zeevro/game-pad/pcb/gamepad-pcb.kicad_pcb

## KiCad design pcb/gamepad-pcb.kicad_pcb (2024-05-09)

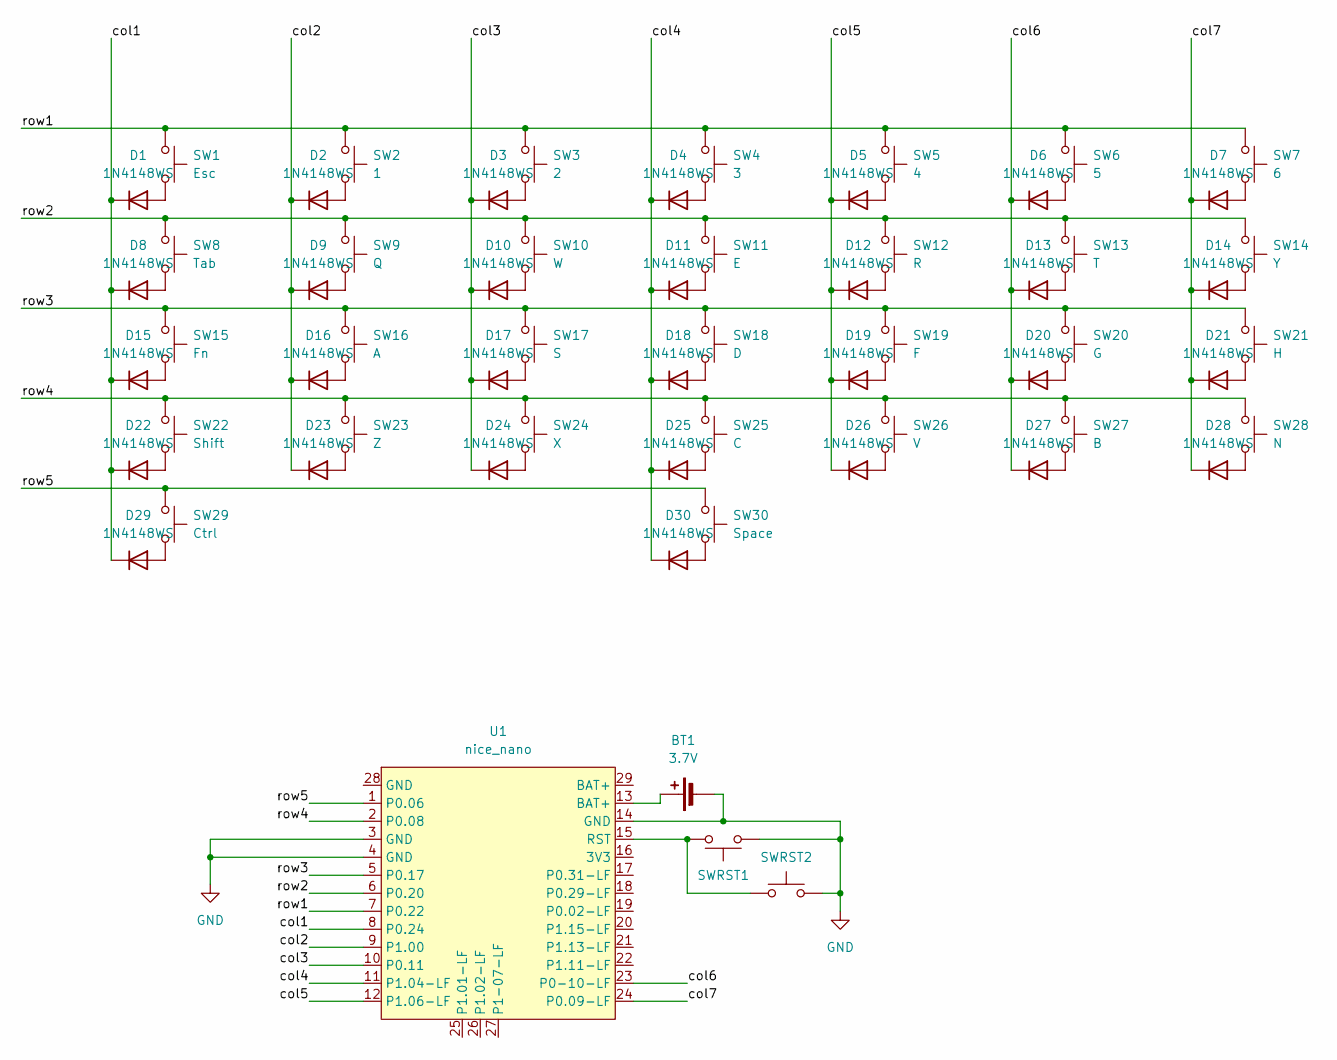
[picture p1: schematic gamepad-pcb.kicad_sch]

Parts:
BT1: 3.7V; PinHeader_1x02_P2.54mm_Vertical
D1, D2, D3, D4, D5, D6, D7, D8, D9, D10, D11, D12, D13, D14, D15, D16, D17, D18, D19, D20, D21, D22, D23, D24, D25, D26, D27, D28, D29, D30: 1N4148WS; D_SOD-323_HandSoldering
SW1: Esc; SW_Cherry_MX_PCB_1.00u
SW2: 1; SW_Cherry_MX_PCB_1.00u
SW3: 2; SW_Cherry_MX_PCB_1.00u
SW4: 3; SW_Cherry_MX_PCB_1.00u
SW5: 4; SW_Cherry_MX_PCB_1.00u
SW6: 5; SW_Cherry_MX_PCB_1.00u
SW7: 6; SW_Cherry_MX_PCB_1.00u
SW8: Tab; SW_Cherry_MX_PCB_1.50u
SW9: Q; SW_Cherry_MX_PCB_1.00u
SW10: W; SW_Cherry_MX_PCB_1.00u
SW11: E; SW_Cherry_MX_PCB_1.00u
SW12: R; SW_Cherry_MX_PCB_1.00u
SW13: T; SW_Cherry_MX_PCB_1.00u
SW14: Y; SW_Cherry_MX_PCB_1.00u
SW15: Fn; SW_Cherry_MX_PCB_1.25u
SW16: A; SW_Cherry_MX_PCB_1.00u
SW17: S; SW_Cherry_MX_PCB_1.00u
SW18: D; SW_Cherry_MX_PCB_1.00u
SW19: F; SW_Cherry_MX_PCB_1.00u
SW20: G; SW_Cherry_MX_PCB_1.00u
SW21: H; SW_Cherry_MX_PCB_1.00u
SW22: Shift; SW_Cherry_MX_PCB_1.75u
SW23: Z; SW_Cherry_MX_PCB_1.00u
SW24: X; SW_Cherry_MX_PCB_1.00u
SW25: C; SW_Cherry_MX_PCB_1.00u
SW26: V; SW_Cherry_MX_PCB_1.00u
SW27: B; SW_Cherry_MX_PCB_1.00u
SW28: N; SW_Cherry_MX_PCB_1.00u
SW29: Ctrl; SW_Cherry_MX_PCB_1.25u
SW30: Space; SW_Cherry_MX_PCB_6.25u
SWRST1, SWRST2: SW_SPST_B3U-1000P
U1: nice_nano; nice_nano_H_USBup

Connections:
/col1: D1.1 (K), D8.1 (K), D15.1 (K), D22.1 (K), D29.1 (K), U1.8 (P0.24)
/col2: D2.1 (K), D9.1 (K), D16.1 (K), D23.1 (K), U1.9 (P1.00)
/col3: D3.1 (K), D10.1 (K), D17.1 (K), D24.1 (K), U1.10 (P0.11)
/col4: D4.1 (K), D11.1 (K), D18.1 (K), D25.1 (K), D30.1 (K), U1.11 (P1.04-LF)
/col5: D5.1 (K), D12.1 (K), D19.1 (K), D26.1 (K), U1.12 (P1.06-LF)
/col6: D6.1 (K), D13.1 (K), D20.1 (K), D27.1 (K), U1.23 (P0-10-LF)
/col7: D7.1 (K), D14.1 (K), D21.1 (K), D28.1 (K), U1.24 (P0.09-LF)
/row1: SW1.1, SW2.1, SW3.1, SW4.1, SW5.1, SW6.1, SW7.1, U1.7 (P0.22)
/row2: SW8.1, SW9.1, SW10.1, SW11.1, SW12.1, SW13.1, SW14.1, U1.6 (P0.20)
/row3: SW15.1, SW16.1, SW17.1, SW18.1, SW19.1, SW20.1, SW21.1, U1.5 (P0.17)
/row4: SW22.1, SW23.1, SW24.1, SW25.1, SW26.1, SW27.1, SW28.1, U1.2 (P0.08)
/row5: SW29.1, SW30.1, U1.1 (P0.06)
GND: BT1.2 (-), SWRST1.2, SWRST2.2, U1.3 (GND), U1.4 (GND), U1.14 (GND)
unnamed: BT1.1 (+), U1.13 (BAT+)
unnamed: D1.2 (A), SW1.2
unnamed: D2.2 (A), SW2.2
unnamed: D3.2 (A), SW3.2
unnamed: D4.2 (A), SW4.2
unnamed: D5.2 (A), SW5.2
unnamed: D6.2 (A), SW6.2
unnamed: D7.2 (A), SW7.2
unnamed: D8.2 (A), SW8.2
unnamed: D9.2 (A), SW9.2
unnamed: D10.2 (A), SW10.2
unnamed: D11.2 (A), SW11.2
unnamed: D12.2 (A), SW12.2
unnamed: D13.2 (A), SW13.2
unnamed: D14.2 (A), SW14.2
unnamed: D15.2 (A), SW15.2
unnamed: D16.2 (A), SW16.2
unnamed: D17.2 (A), SW17.2
unnamed: D18.2 (A), SW18.2
unnamed: D19.2 (A), SW19.2
unnamed: D20.2 (A), SW20.2
unnamed: D21.2 (A), SW21.2
unnamed: D22.2 (A), SW22.2
unnamed: D23.2 (A), SW23.2
unnamed: D24.2 (A), SW24.2
unnamed: D25.2 (A), SW25.2
unnamed: D26.2 (A), SW26.2
unnamed: D27.2 (A), SW27.2
unnamed: D28.2 (A), SW28.2
unnamed: D29.2 (A), SW29.2
unnamed: D30.2 (A), SW30.2
unnamed: SWRST1.1, SWRST2.1, U1.15 (RST)

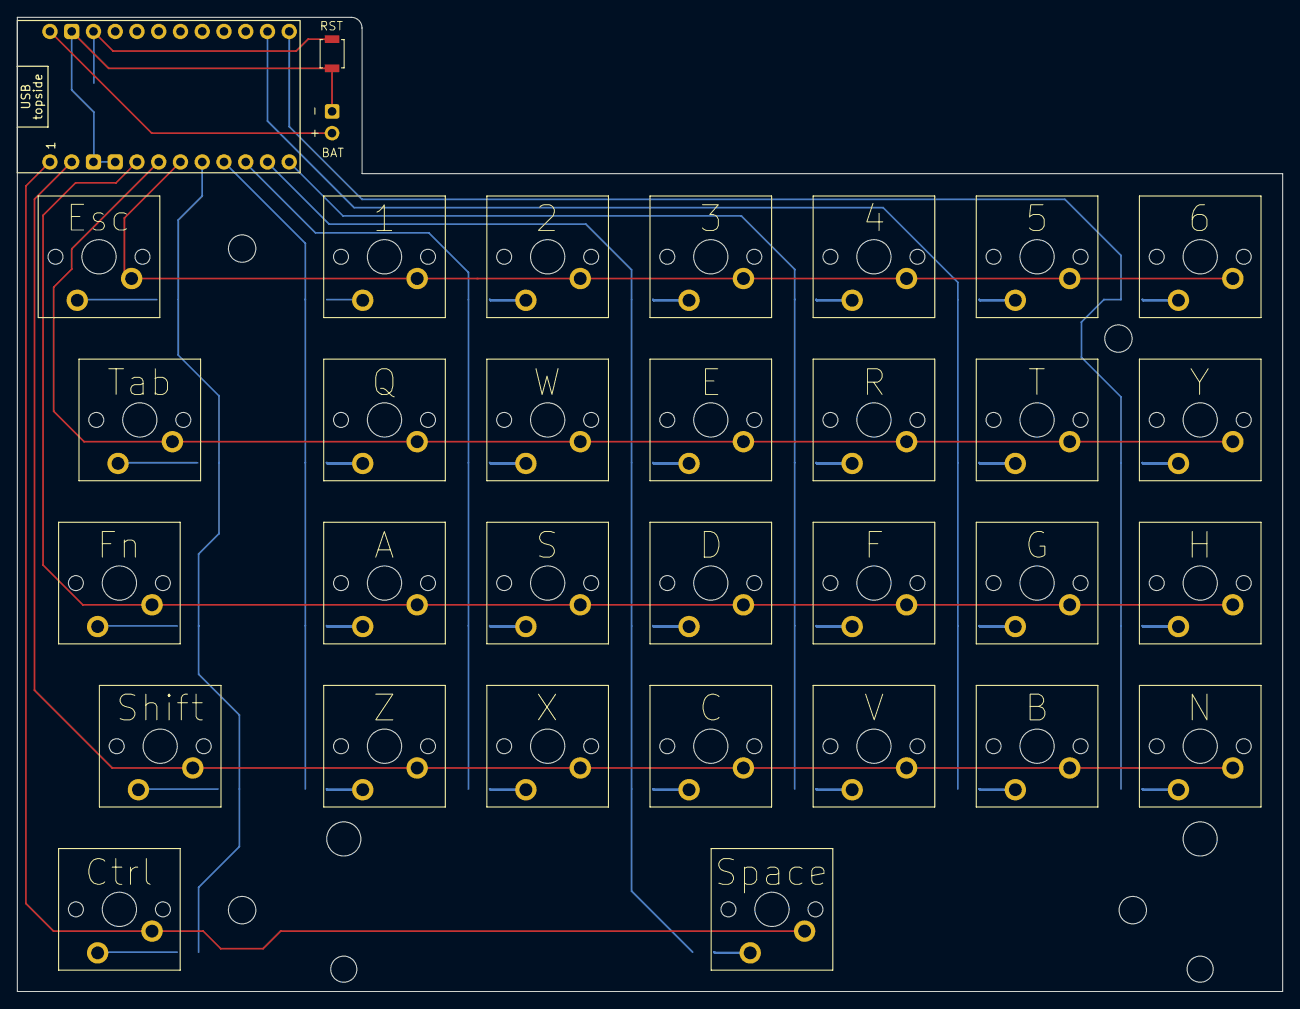
[picture p2: board gamepad-pcb.kicad_pcb from above]

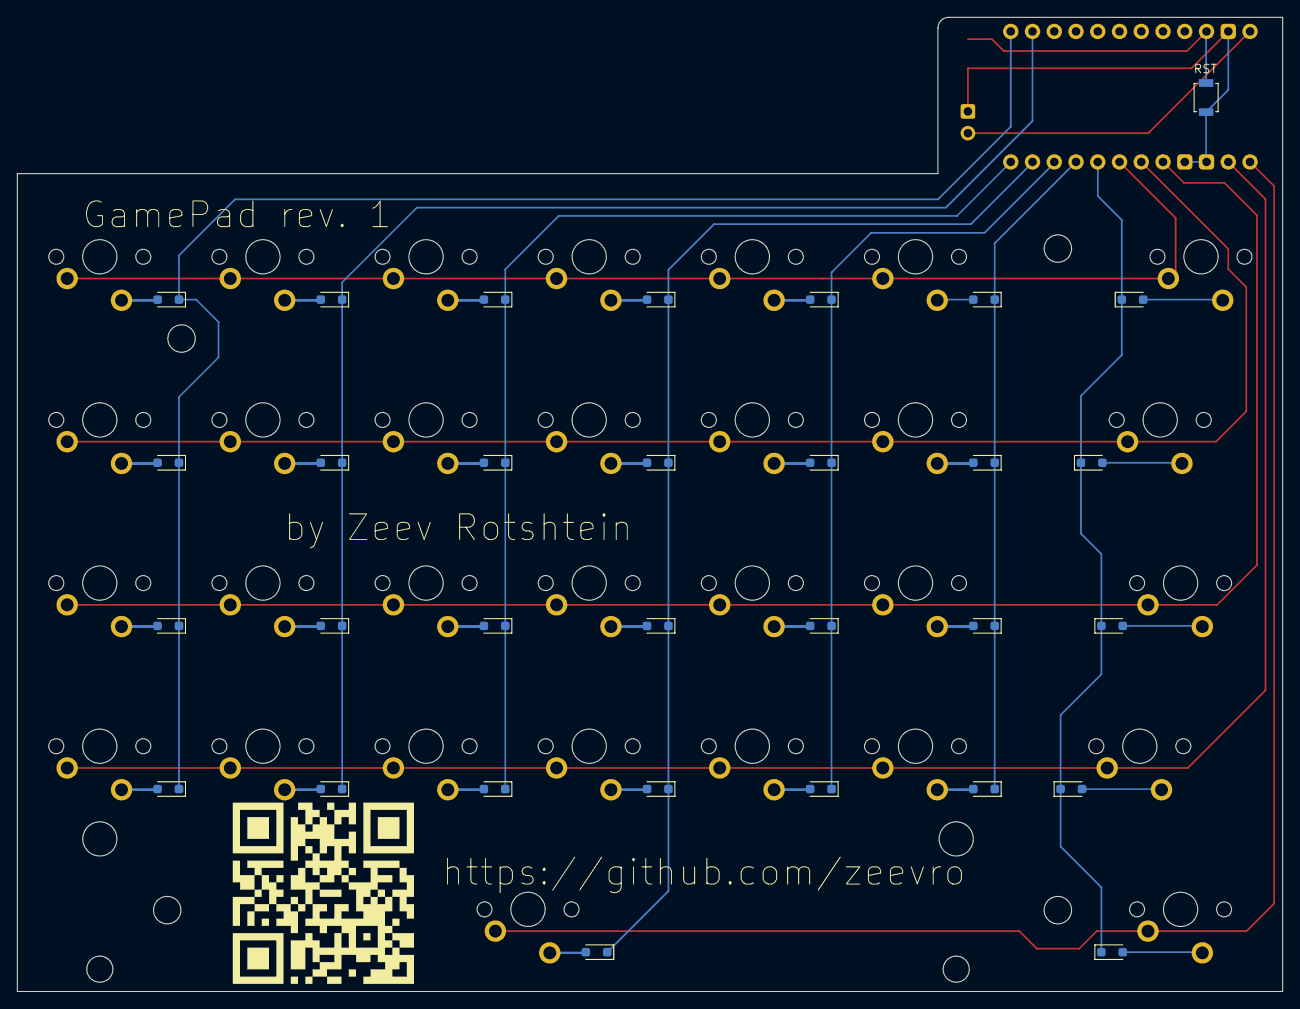
[picture p3: board gamepad-pcb.kicad_pcb from below]

Board: 2 copper layers, 147.8 x 113.8 mm, 70 parts (32 on the bottom side), 45 nets.

Other parts of the board:
MH1, MH2, MH3, MH3#2: MountingHole_3.2mm_M3
QR: LOGO
ST30: Stabilizer_Cherry_MX_6.25u
