zeevro/game-pad/(commit log)

2024-05-12 wip 1
    [gamepad-case.scad]
2024-05-16 wip 2
    [gamepad-case.scad]
